TimChien112/LPM-final-project/component reference files/PCB layout pictures/TPS62822(BUCK).JPG

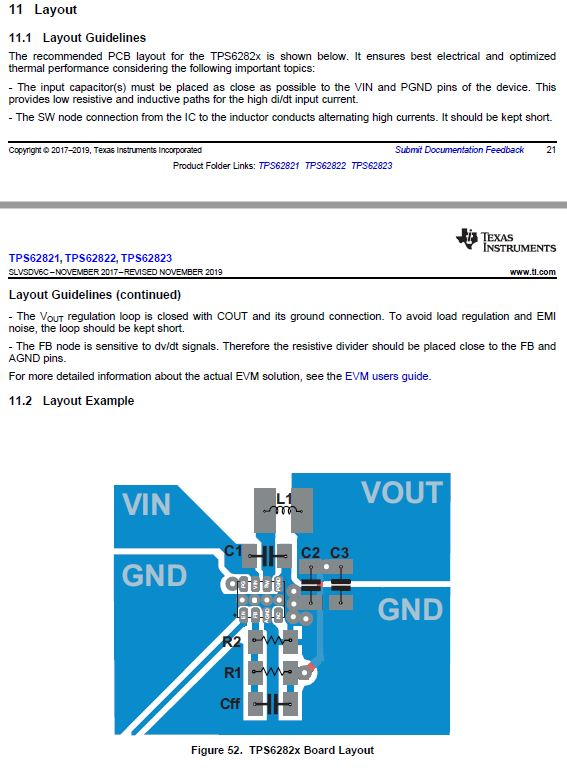
component reference files/PCB layout pictures/TPS62822(BUCK).JPG
