TimChien112/LPM-final-project/component reference files/PCB layout pictures/GPS.JPG

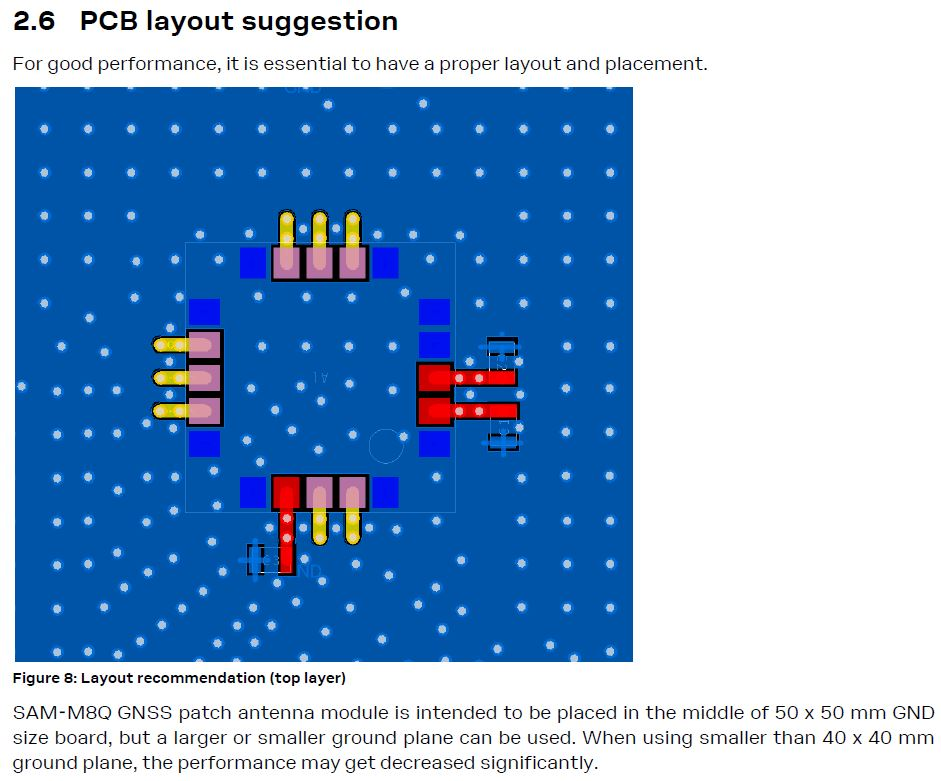
component reference files/PCB layout pictures/GPS.JPG
