TimChien112/LPM-final-project/component reference files/recommended Schematics/BQ2407x DK sch.JPG

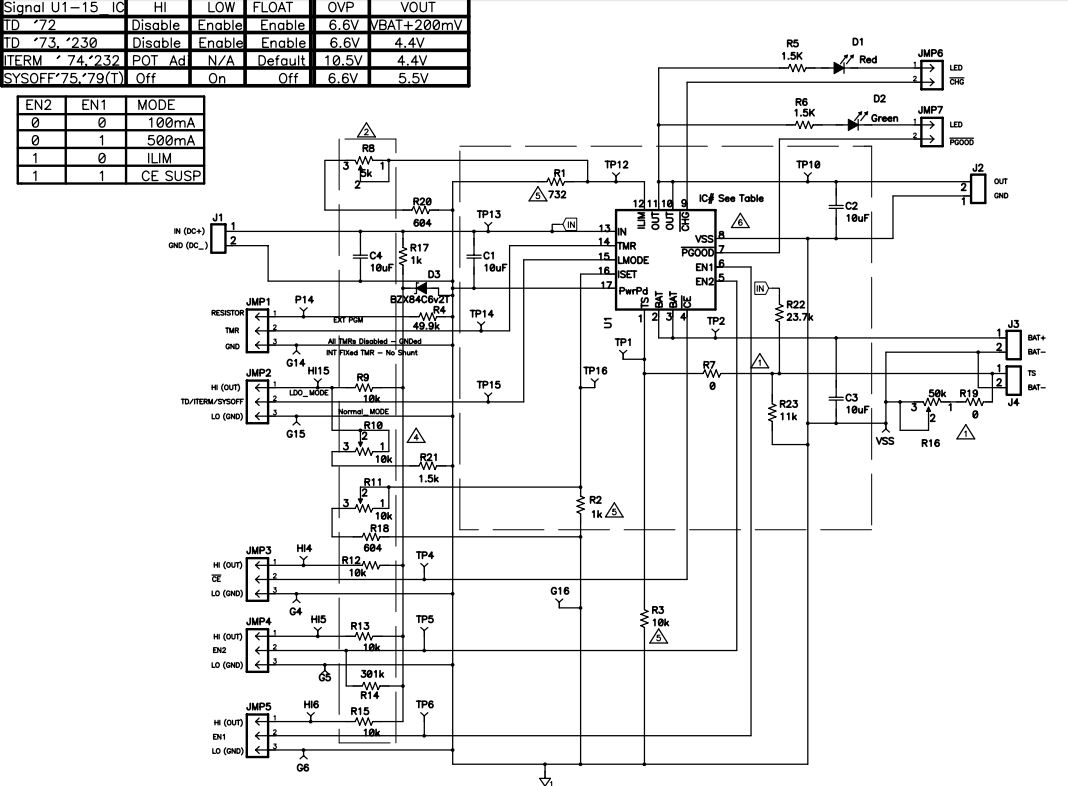
component reference files/recommended Schematics/BQ2407x DK sch.JPG
