TimChien112/LPM-final-project/component reference files/recommended Schematics/BQ24079  sch.JPG

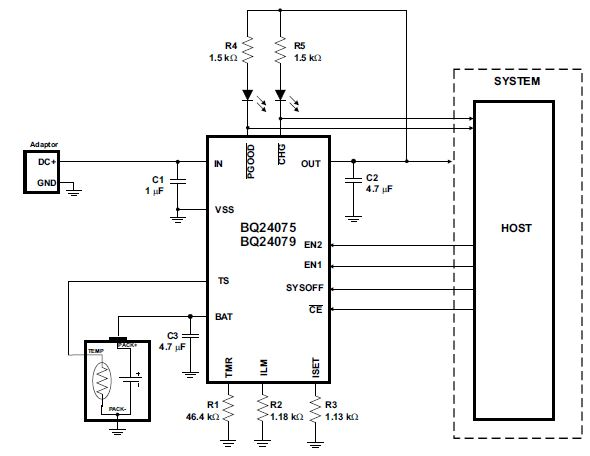
component reference files/recommended Schematics/BQ24079 sch.JPG
