TimChien112/LPM-final-project/component reference files/recommended Schematics/TPS2111a DK sch.JPG

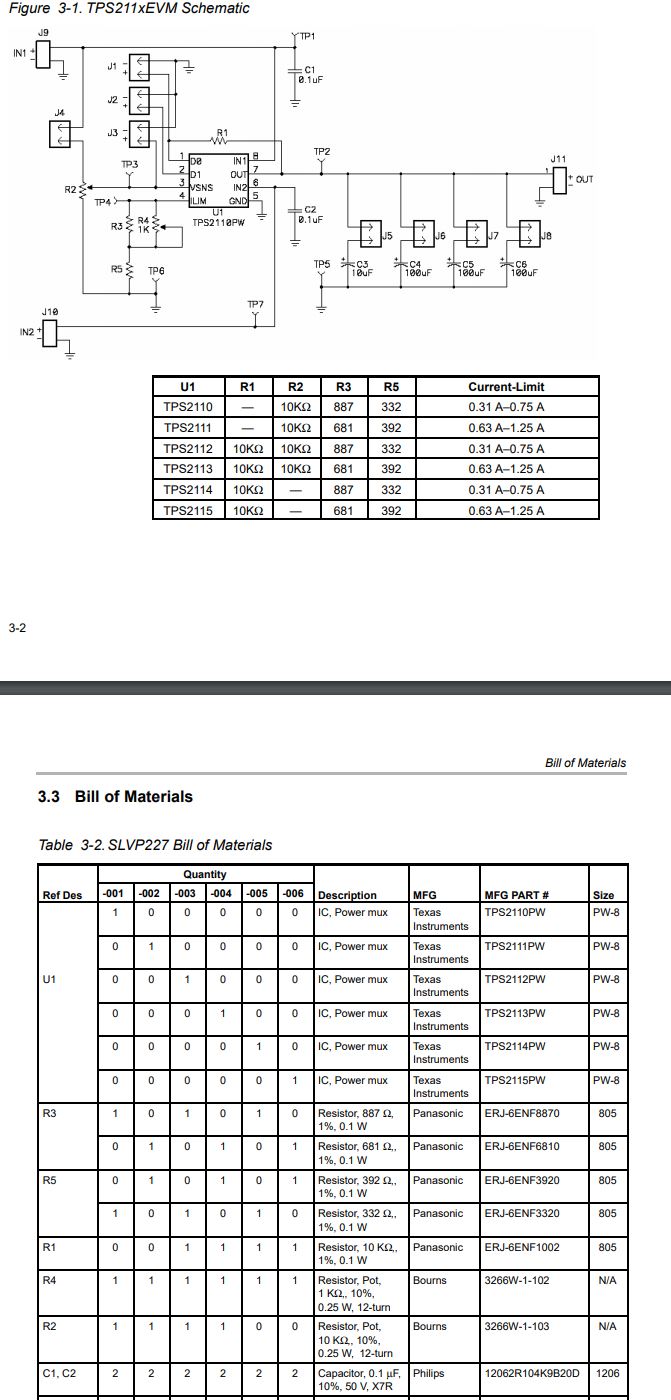
component reference files/recommended Schematics/TPS2111a DK sch.JPG
