TimChien112/LPM-final-project/component reference files/MCU/EFR32MG1-BRD4154A-A00-bom.xlsx

P/N: | BRD4154A
Revision: | A00
Description: | EFR32MG Firefly 2.4 GHz 19.5 dBm Radio Board
Revised: | Wednesday, April 06, 2016
Item | Quantity | Reference | Value | Manufacturer | Manufacturers Part Number | Description | Tolerance | Rating | Technology | Not Mounted
1 | 1 | AT1 | INVERTED_F
2 | 1 | C1 | 2P0 | Murata | GRM1555C1H2R0WA01 | CAP CER C0G 2pF 50V +-0.05pF | ±0.05P | 50V | C0G
3 | 1 | C2 | 1P0 | Murata | GRM1555C1H1R0WA01 | CAP CER C0G 1.0pF 50V +-0.05pF | ±0.05P | 50V | C0G
4 | 1 | C102 | 100P |  |  | CAP CER C0G 100pF 50V 5% | 5% | 50V | C0G
5 | 2 | C103,C107 | 10P |  |  | CAP CER NP0 10pF 50V 5% | 5% | 50V | C0G
6 | 1 | C106 | 220N |  |  | CAP CER X7R 220nF 16V 10% | 10% | 16V | X7R
7 | 2 | C110,C123 | 10U |  |  | CAP CER X5R 10uF 6.3V 20% | 20% | 6.3V | X5R
8 | 4 | C111,C115,C116,C118 | 1U |  |  | CAP CER X5R 1uF 25V 10% | 10% | 25V | X5R
9 | 1 | C113 | 10N |  |  | CAP CER X7R 10nF 16V 10% | 10% | 16V | X7R
10 | 6 | C119,C200,C201,C203,C207,C209 | 100N |  |  | CAP CER X7R 100nF 16V 10% | 10% | 16V | X7R
11 | 1 | C205 | 10U |  |  |  |  |  | X5R | NM
12 | 1 | L1 | 1N8 | Murata | LQP15MN1N8W02 | INDUCTOR 1.8nH 280mA +-0.05nH | ±0.05N
13 | 1 | L2 | 3N0 | Murata | LQP15MN3N0W00 | INDUCTOR 3.0nH 190mA +-0.05nH | ±0.05N
14 | 1 | L100 | CBF102WB | Würth Electronics | 74279266 | FERRITE BEAD 1000R 200mA
15 | 1 | L101 | 4U7 | Murata | LQH3NPN4R7MM0L | INDUCTOR POWER 4.7uH 1.25A 20%
16 | 2 | L102,L103 | BLM18AG601SN1 | Murata | BLM18AG601SN1
17 | 1 | PCB1 | PCB4154A |  | PCB4154A Rev. A01
18 | 1 | P1 | U.FL | Hirose | U.FL-R-SMT-1
19 | 2 | P200,P201 | SOCKET_2X20_1.27MM_SMD | Samtec | SFC-120-T2-L-D-A-K-TR | CONN SOCKET STRIP 1.27mm
20 | 3 | R1,R201,R210 | 0R |  |  | RES 0R Imax 2A JUMPER
21 | 2 | R2,R211 | 0R |  |  |  |  |  |  | NM
22 | 1 | R100 | 1R |  |  | RES 1R 1/16W 1% 200ppm
23 | 1 | R200 | 10K |  |  | RES 10K 1/16W 1% 100ppm
24 | 4 | R202,R203,R204,R205 | 4K7 |  |  | RES 4K7 1/16W 1% 100ppm
25 | 1 | SH100 | RF_SHIELD_FRAME_BMI-S-203-F | Laird Technologies | BMI-S-203-F |  |  |  |  | NM
26 | 1 | SH101 | RF_SHIELD_COVER_BMI-S-203-C | Laird Technologies | BMI-S-203-C |  |  |  |  | NM
27 | 17 | TPJ1,TPJ2,TPJ3,TPJ4,TPJ5,TPJ6,TPJ7,TPJ8,TPJ9,TPJ10,TPJ11,TPJ12,TPJ13,TPJ14,TPJ15,TPJ16,TPJ17 | TPJ_SMD
28 | 1 | U1 | EFR32MG1P732F256GM32 | Silicon Labs | EFR32MG1P732F256GM32-B0
29 | 1 | U200 | 24AA024 | Microchip | 24AA024T-I/MNY | IC EEPROM 2KBIT SERIAL
30 | 1 | U201 | EFM8SB10F8G-QFN20 | Silicon Labs | EFM8SB10F8G-A-QFN20 | IC MCU
31 | 1 | X1 | 38.4MHz | KDS | DSX211SH 38.4 MHz 1ZZNAE38400AB0A
32 | 1 | X2 | 32.768kHz | Micro Crystal AG | CM8V-T1A, 32768Hz, 12.5pF, +/- 20ppm
