TimChien112/LPM-final-project/Project Outputs for PCB_Project/PCB_Project.xlsx

Comment | Description | Designator | Footprint | LibRef | Quantity
1206C 100NF |  | C1, C2 | 1206-CAP | 1206C 100NF | 2 | 10
0805C 10UF |  | C3, C4 | 0805-CAP | 0805C 10UF | 2 | 10
0603C 4U7F |  | C5, C19, C25, C27 | 0603-CAP | 0603C 4U7F | 4 | 12
0603C 120PF |  | C6 | 0603-CAP | 0603C 120PF | 1 | 3
1210C 22UF |  | C7, C8 | 1210-CAP | 1210C 22UF | 2 | 3
0603C 10UF |  | C9, C15, C21, C31 | 0603-CAP | 0603C 10UF | 4 | 12
0603C 1UF |  | C10, C20, C22 | 0603-CAP | 0603C 1UF | 3 | 10
0603C 10NF |  | C11, C12, C13, C14, C16, C17, C32 | 0603-CAP | 0603C 10NF | 7 | 21
0603C 100NF |  | C18, C23, C24, C26, C34 | 0603-CAP | 0603C 100NF | 5 | 15
47uF |  | C28, C29, C30 | 0805-CAP | 0805C 47UF | 3 | 10
0603C 68PF |  | C33 | 0603-CAP | 0603C 68PF | 1 | 3
LEDR |  | D1, D4 | 0603-LED | 0603 LEDR | 2 | 10
LEDG |  | D2, D3, D5, D6 | 0603-LED | 0603 LEDG | 4 | 13
ESD_USB |  | E1 | ESD_USB | ESD_USB | 1 | 3
ESD_RS |  | E2, E3 | ESD_RS | ESD_RESET | 2 | 6
Inductor 470NH |  | L1 | Inductor 470NH | Inductor 470NH | 1 | 3
Ferrite Bead |  | L2 | 0603-FerritBead | Ferrite Bead | 1 | 3
Inductor 4U7H |  | L3 | Inductor 4U7H | Inductor 4U7H | 1 | 3
2pins_connector | Bat_connector | P1, P2 | 2_PINS_2.54 | 2pins_connector | 2
ZX62D-B-5P8 | USB - micro B USB 2.0 Receptacle Connector 5 Position Surface Mount, Right Angle; Through Hole | P3 | *HRS_ZX62D-B-5P8_ZX62D-B-5P8(Primary) | ZX62D-B-5P8 | 1 | 3
SWO |  | P4 | 4_PINS_2.54 | 4pins_connector | 1
6pins_connector |  | P5 | 6_PINS_2.54 | 6pins_connector | 1
0805R 5K1R |  | R1, R2 | 0805-RES | 0805R 5K1R | 2 | 10
0603R 1KR |  | R3, R6 | 0603-RES | 0603R 1KR | 2 | 10
0603R 1K5R |  | R4, R5, R28, R31 | 0603-RES | 0603R 1K5R | 4 | 12
0603R 1K07R |  | R7 | 0603-RES | 0603R 1K07R | 1 | 20 | ?
0603R 46K4R |  | R8 | 0603-RES | 0603R 46K4R | 1 | 10
0603R 10KR |  | R9, R21, R22, R23 | 0603-RES | 0603R 10KR | 4 | 12
0805R 100KR |  | R10, R12 | 0805-RES | 0805R 100KR | 2 | 10
0805R 453KR |  | R11 | 0805-RES | 0805R 453KR | 1 | 3
3KR |  | R13, R14 | 0603-RES | 0603R 3KR | 2 | 10
0603R NC |  | R15, R16, R17, R18 | 0603-RES | 0603R NC | 4
0603R 1R |  | R19, R24, R25, R29, R30 | 0603-RES | 0603R 1R | 5 | 15
0603R 100R |  | R20, R32 | 0603-RES | 0603R 100R | 2 | 10
0603R 47R |  | R26, R27 | 0603-RES | 0603R 47R | 2 | 10
PTS810 | Tactile Switch SPST-NO Top Actuated Surface Mount | SW1, SW2 | *SW_PTS810_SJM_250_SMTR_LFS | PTS810_SJM_250_SMTR_LFS | 2 | 6
1pin_header |  | T1, T2, T3, T4, T5, T6, T7 | 1_PIN_2.54 | 1pin_header | 7
1pin_test |  | T8, T9, T10 | 1_PIN_test | 1pin_test | 3
 |  | T11, T12, T13, T14 | 1_PIN_test | 1pin_header | 4
 |  | T15 | 1_PIN_2.54 | 1pin_header | 1
TPS2111APW | OR Controller Source Selector Switch N-Channel 2:1 8-TSSOP | U1 | *SOP65P640X120-8N | TPS2111APW | 1 | 3
BQ24079TRGTR |  | U2 | *QFN50P300X300X100-17N | BQ24079TRGTR | 1 | 3
TPS62822 |  | U3 | SON50P150X100_HS-9N | TPS62822 | 1 | 3
EFM32PG12_power |  | U4 | QFN50P700X700X90_HS-49N_ | EFM32PG12 | 1 | 3
MMA8452Q | Accelerometer X, Y, Z Axis , 2g, 4g, 8g 0.78Hz ~ 400Hz 16-QFN _3x3_ | U5 | *QFN-16_0.5MM | MMA8452Q | 1 | 3
SAM-M8Q-0-10 | CAM-M8 RF Receiver BeiDou, GLONASS, GNSS, GPS 1.575GHz -167dBm On-Board, Chip Module | U6 | SAMM8Q010 | SAM-M8Q-0-10 | 1 | 2
XB3-C-A1-UT-001 |  | U7 | XB24CAPIT-001 | XB3-C-A1-UT-001 | 1
battery |  |  |  |  | 1 | 1
solar |  |  |  |  | 1 | 1
