TimChien112/LPM-final-project/component reference files/PCB layout pictures/Accelerometer.JPG

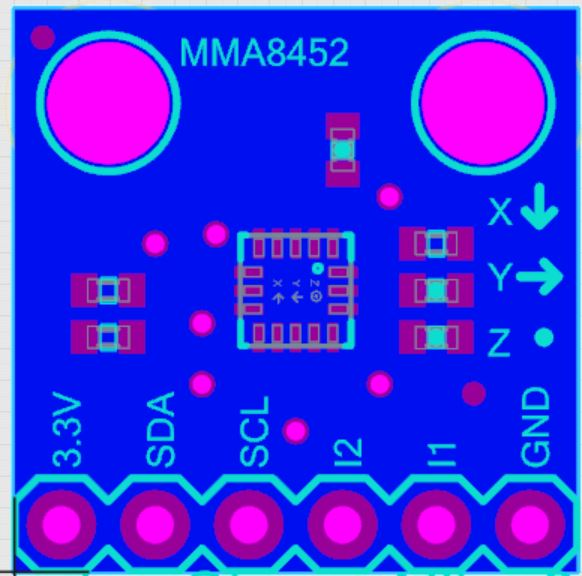
component reference files/PCB layout pictures/Accelerometer.JPG
