TimChien112/LPM-final-project/component reference files/PCB layout pictures/BQ24079(PMU).JPG

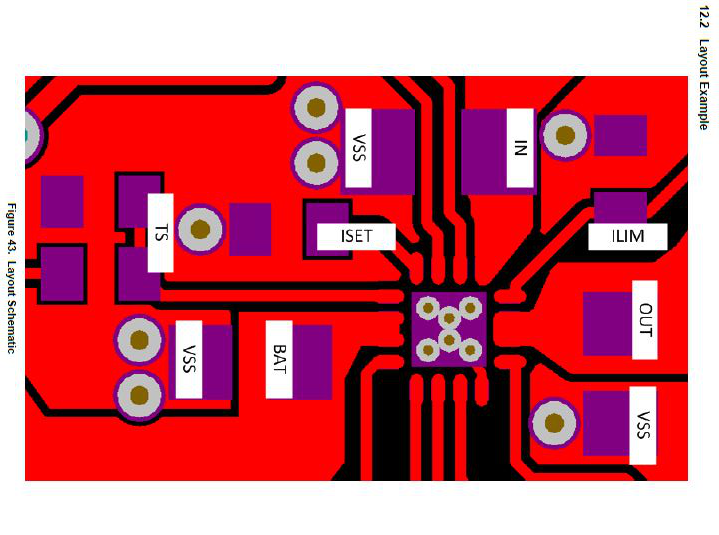
component reference files/PCB layout pictures/BQ24079(PMU).JPG
