TimChien112/LPM-final-project/component reference files/PCB layout pictures/ideal diode DK.JPG

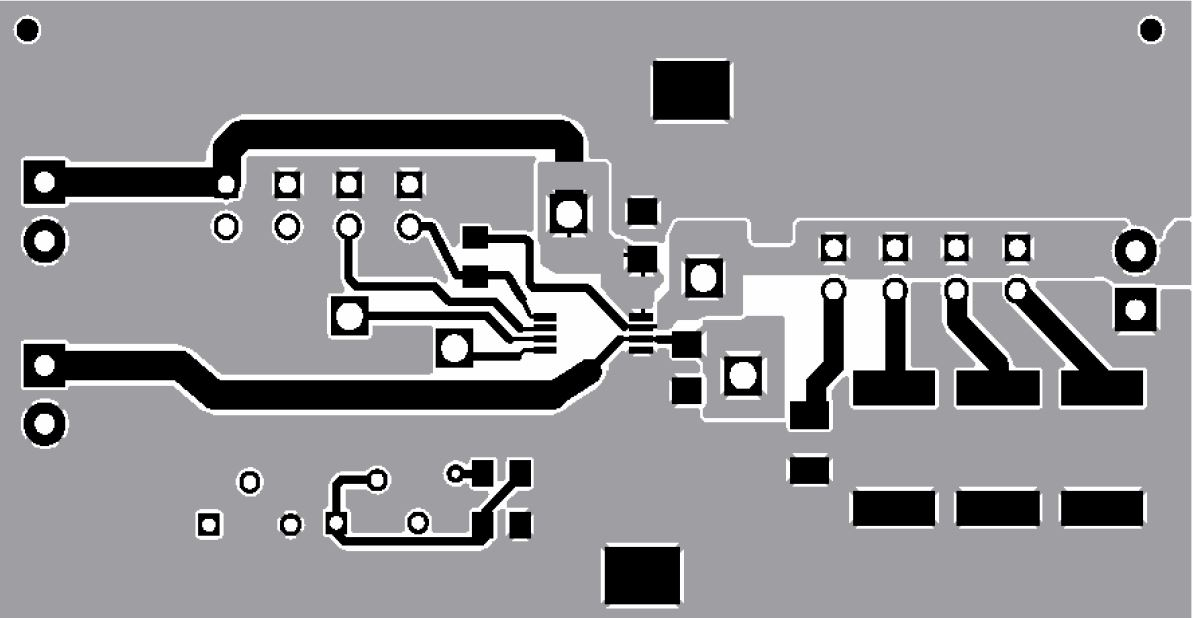
component reference files/PCB layout pictures/ideal diode DK.JPG
