TimChien112/LPM-final-project/component reference files/PCB layout pictures/LTE.JPG

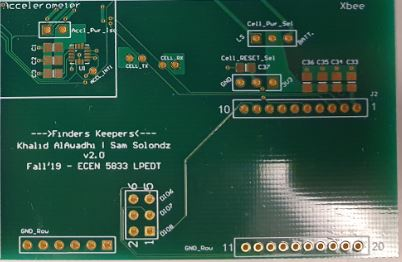
component reference files/PCB layout pictures/LTE.JPG
