TimChien112/LPM-final-project/component reference files/Unpopulated_back.jpg

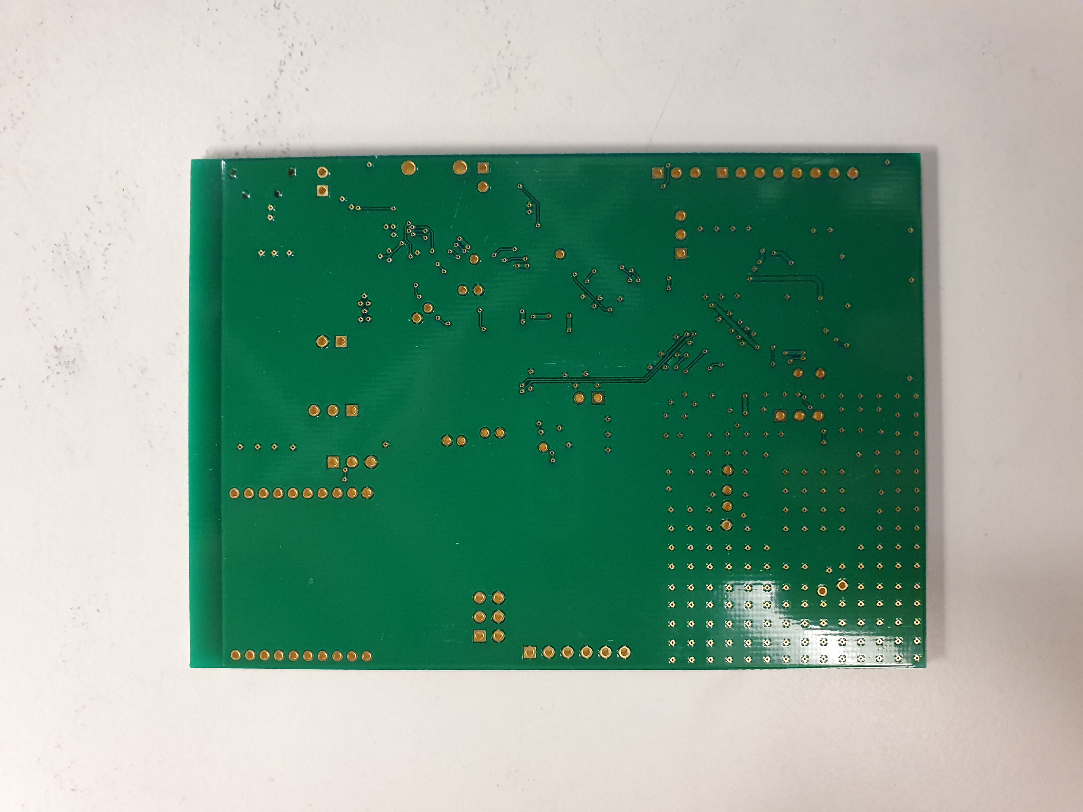
component reference files/Unpopulated_back.jpg
