TimChien112/LPM-final-project/component reference files/Unpopulated_front.jpg

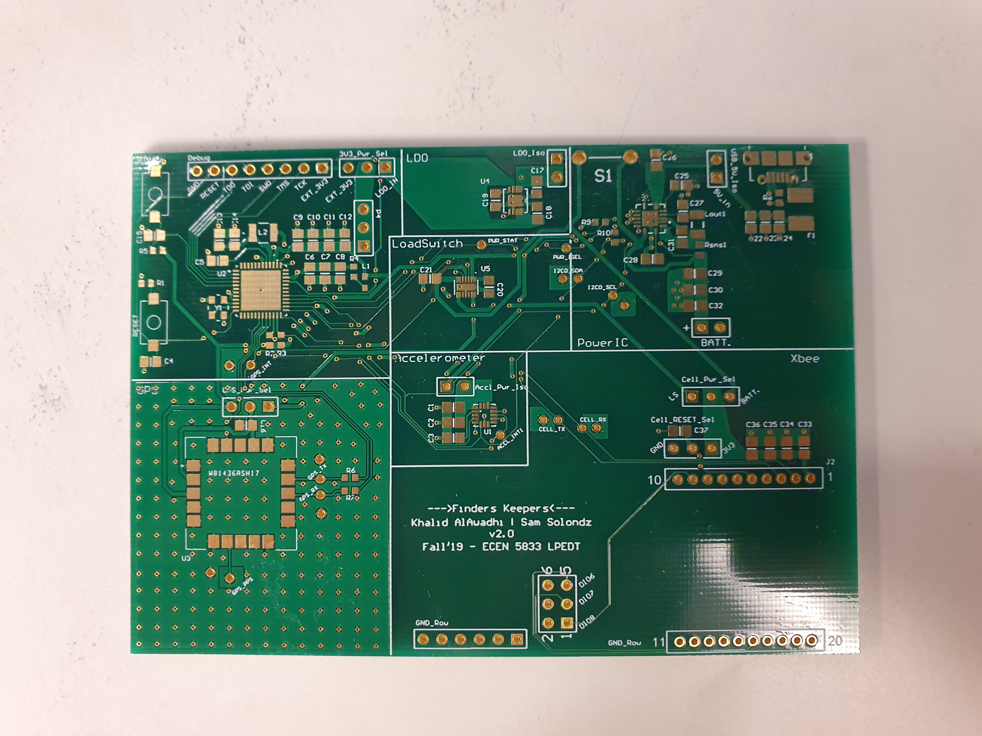
component reference files/Unpopulated_front.jpg
