TimChien112/LPM-final-project/PCB_Project.pdf

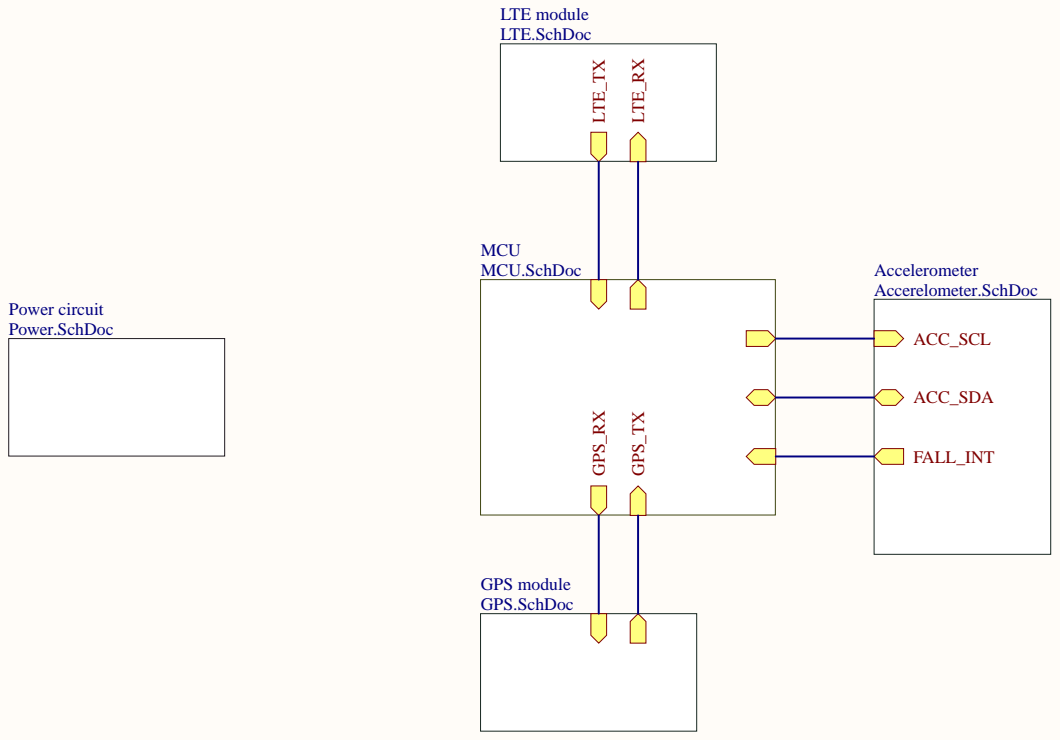
[picture p32: page 1]

Block diagram Title | *

Size: A4 | Number: 1. 1-1 | Revision:
2020/4/26 下午 10:35:18 Date: Time: | | Sheet of

C:\Users\Tim Chien\Google 雲端硬碟\LPM project\hardware\LPM-final-project\Block digram.SchDoc

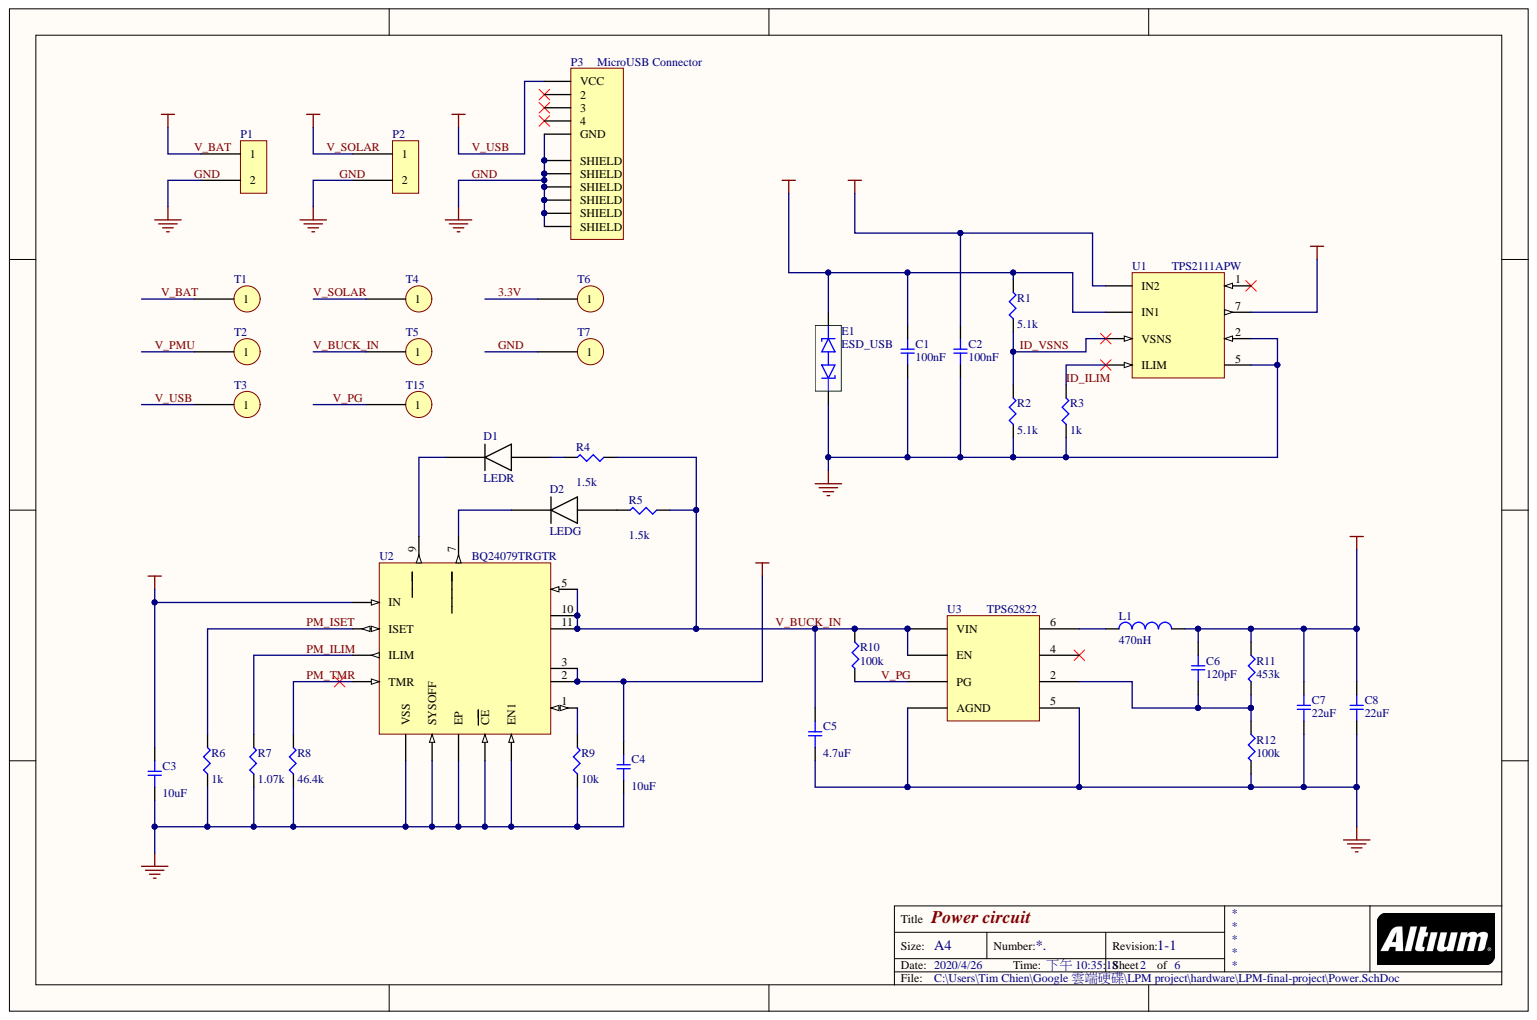
[picture p33: page 2]

PM_ISET

PM_ILIM | R10

Power circuit Title | * *

Size: A4 | Number: *. | Revision: 1-1

C:\Users\Tim Chien\Google 雲端硬碟\LPM project\hardware\LPM-final-project\Power.SchDoc

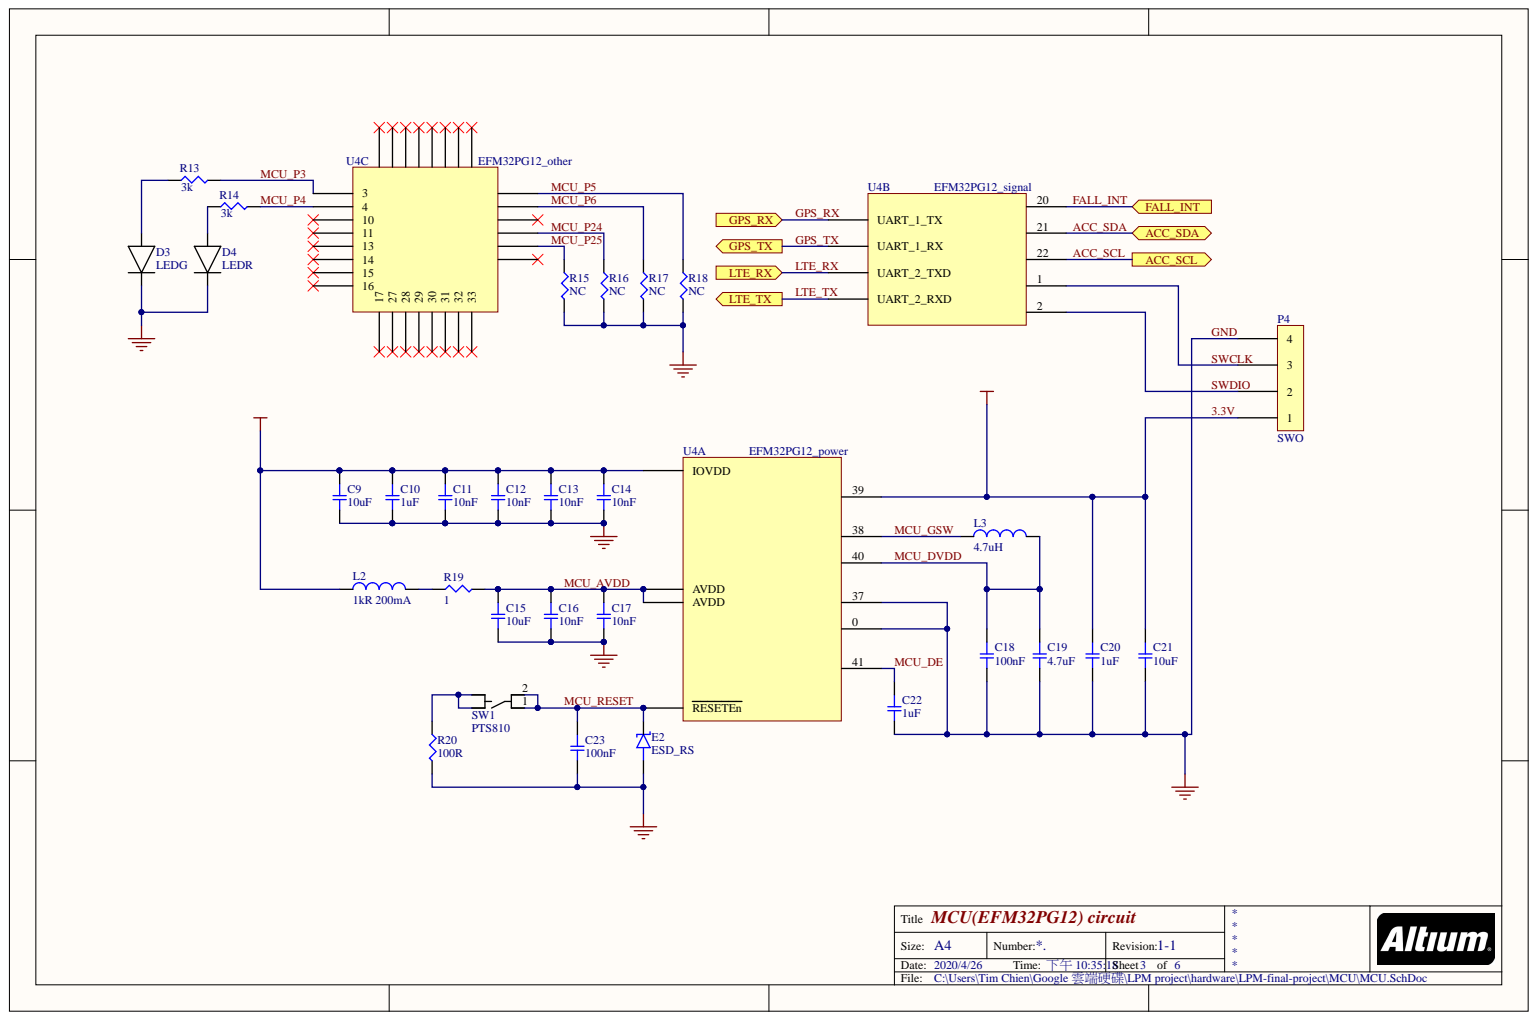
[picture p34: page 3]

MCU_P6

MCU_P24
MCU_P25

SWCLK

SWDIO

MCU(EFM32PG12) circuit Title | * *

Size: A4 | Number: *. | Revision: 1-1

C:\Users\Tim Chien\Google 雲端硬碟\LPM project\hardware\LPM-final-project\MCU\MCU.SchDoc

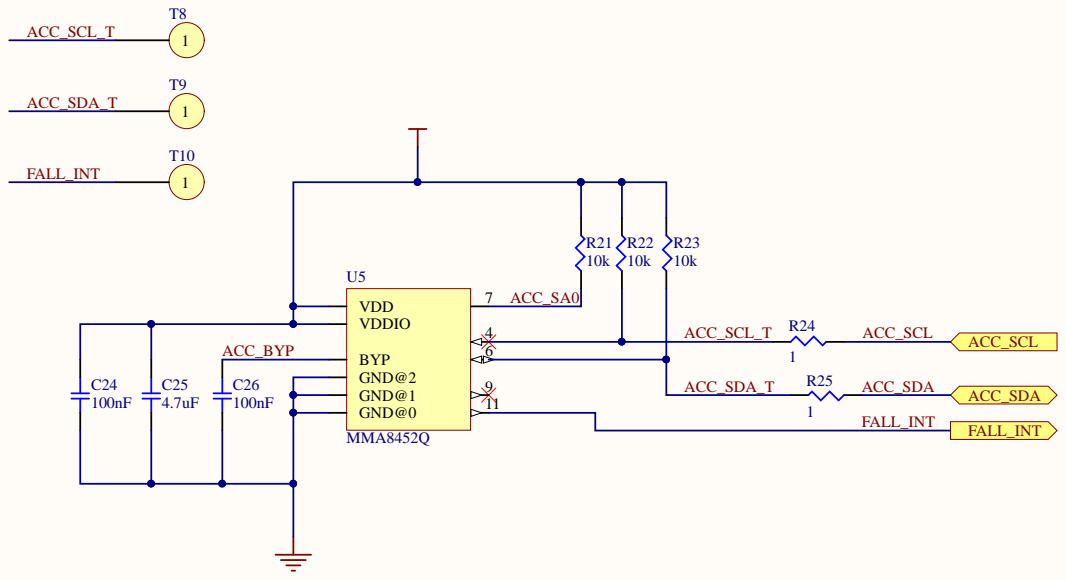
[picture p35: page 4]

Accelerometer (MMA8452Q) circuit Title | * *

Size: A4 | Number: *. | Revision: 1-1

C:\Users\Tim Chien\Google 雲端硬碟\LPM project\hardware\LPM-final-project\Acceleormeter\Accerelometer.SchDoc

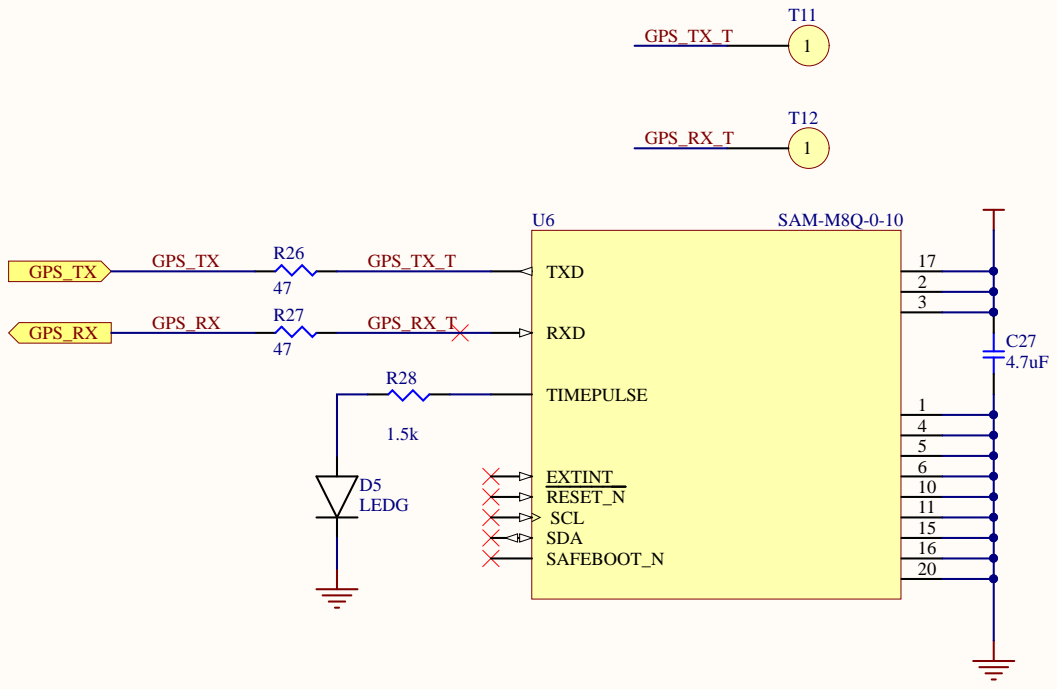
[picture p36: page 5]

GPS (SAM-M8Q) circuit Title | * *

Size: A4 | Number: *. | Revision: 1-1

C:\Users\Tim Chien\Google 雲端硬碟\LPM project\hardware\LPM-final-project\CAM-M8Q-0 Lib\GPS.SchDoc

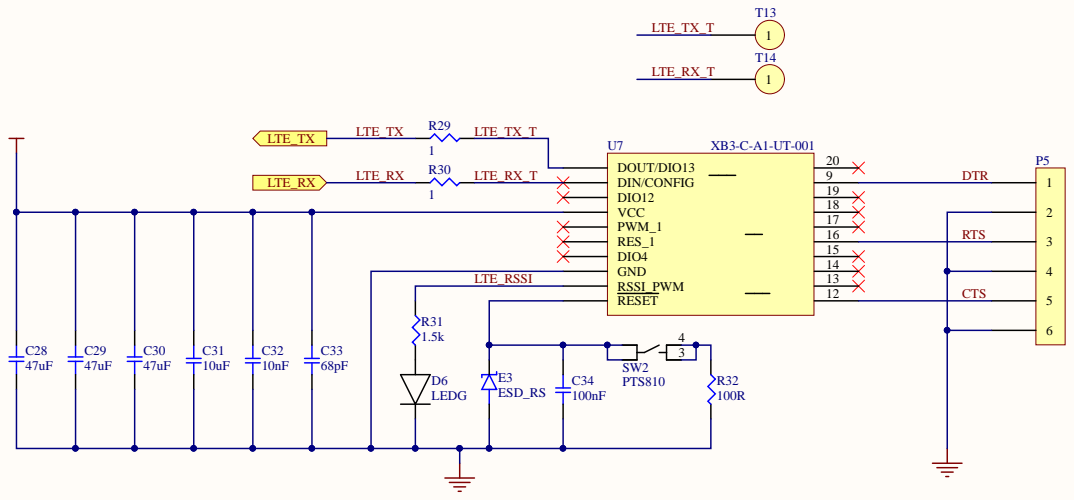
[picture p37: page 6]

LTE (XB3-C-A1-UT) circuit Title | *

Size: A4 | Number: *. | Revision: 1-1

C:\Users\Tim Chien\Google 雲端硬碟\LPM project\hardware\LPM-final-project\LTE\LTE.SchDoc

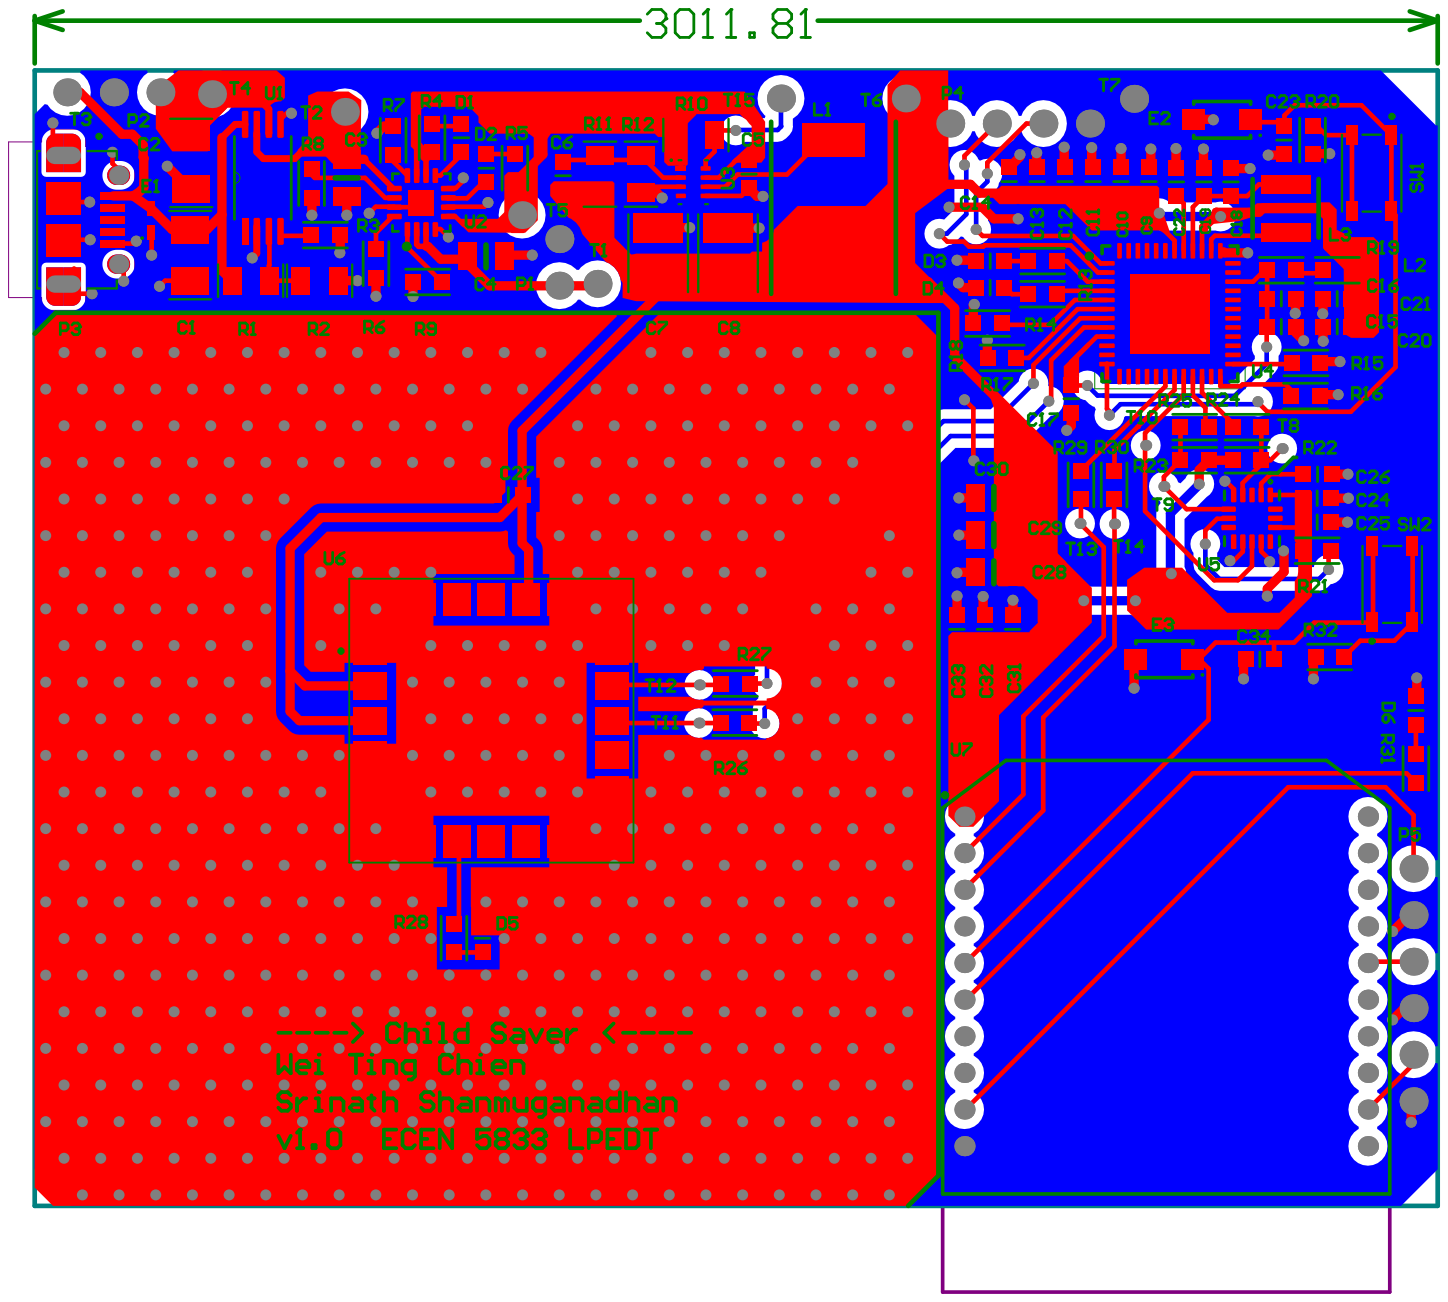
[picture p38: page 7]
