TimChien112/LPM-final-project/(list of files, drawings)

Other design files:
Acceleormeter/Accerelometer.SchDoc
Acceleormeter/MMA8452Q.PcbLib
Acceleormeter/MMA8452Q.SchLib
battery Management IC/BQ24079TRGTR.PcbLib
battery Management IC/BQ24079TRGTR.SchLib
battery Management IC/BQ24210DQCR.PcbLib
battery Management IC/BQ24210DQCR.SchLib
Block digram.SchDoc
Buck regulator/buck regulator.PcbLib
Buck regulator/TPS62822.PcbLib
Buck regulator/TPS62822.SchLib
CAM-M8Q-0 Lib/CAM-M8Q-0.PcbLib
CAM-M8Q-0 Lib/CAM-M8Q-0.SchLib
CAM-M8Q-0 Lib/GPS.PcbLib
CAM-M8Q-0 Lib/GPS.SchDoc
CAM-M8Q-0 Lib/GPS.SchLib
Connector/2.54_Connectors.SchLib
Connector/Connectors.PcbLib
Connector/ZX62D-B-5P8.PcbLib
Connector/ZX62D-B-5P8.SchLib
Connectors.SchLib
ideal diode/TPS2111APW.PcbLib
ideal diode/TPS2111APW.SchLib
LED/LED.SchLib
LTE/LTE.PcbLib
LTE/LTE.SchDoc
LTE/XBee_LTE.SchLib
MCU/EMF32PG.SchLib
MCU/EMF32QFN48PcbLib.PcbLib
MCU/MCU.SchDoc
passive components.PcbLib
passive components.SchLib
PCB_Project.PrjPcb
PCB_v1.PcbDoc
Power.SchDoc
switch/PTS810_SJM_250_SMTR_LFS.PcbLib
switch/PTS810_SJM_250_SMTR_LFS.SchLib
