TimChien112/LPM-final-project/(commit log)

2020-03-18 first commit for previous files
    [2.54_Connectors.SchLib, Accerelometer.SchDoc, BQ24079TRGTR.PcbLib, BQ24079TRGTR.SchLib, BQ24210DQCR.PcbLib, BQ24210DQCR.SchLib, Block digram.SchDoc, CAM-M8Q-0.PcbLib]
2020-03-18 add component reference files
    [EFR32MG1-BRD4154A-A00-bom.xlsx]
2020-03-19 Fixed one set of warning, added symbols, removed R from resistor
    [Accerelometer.SchDoc, GPS.SchDoc, LTE.SchDoc, MCU.SchDoc, Power.SchDoc, passive components.SchLib]
2020-03-19 schematic changes
    [Accerelometer.SchDoc, GPS.SchLib, MCU.SchDoc, Power.SchDoc, passive components.SchLib]
2020-03-19 3/10 03:55 schematic freeze
    [Accerelometer.SchDoc, BQ24079TRGTR.SchLib, GPS.SchDoc, GPS.SchLib, LTE.SchDoc, MCU.SchDoc, PCB_v1.PcbDoc, Power.SchDoc]
2020-03-20 PCB layout 3/20 freeze
    [2.54_Connectors.SchLib, Accerelometer.SchDoc, EMF32QFN48PcbLib.PcbLib, GPS.PcbLib, GPS.SchDoc, GPS.SchLib, LTE.SchDoc, MCU.SchDoc]
2020-03-21 PCB layout freezed 3/21
    [Accerelometer.SchDoc, LTE.SchDoc, MCU.SchDoc, PCB_v1.PcbDoc, Power.SchDoc, passive components.SchLib]
2020-03-23 fix layout problem 3/22
    [Connectors.PcbLib, PCB_v1.PcbDoc, Power.SchDoc, passive components.PcbLib]
2020-03-24 fix review 1 problems, except the thermal pad problems
    [2.54_Connectors.SchLib, Accerelometer.SchDoc, BQ24079TRGTR.PcbLib, Connectors.PcbLib, EMF32QFN48PcbLib.PcbLib, GPS.SchDoc, LTE.SchDoc, PCB_Project.PrjPcb]
2020-03-24 3/24 designators re-arrangement
    [Accerelometer.SchDoc, EMF32QFN48PcbLib.PcbLib, MCU.SchDoc, PCB_v1.PcbDoc]
2020-03-25 add USB connector
    [2.54_Connectors.SchLib, Connectors.PcbLib, PCB_v1.PcbDoc, Panasonic_ERJ_0603.PcbLib, Panasonic_ERJ_0805.PcbLib, Power.SchDoc, ZX62D-B-5P8.PcbLib, ZX62D-B-5P8.SchLib]
2020-03-25 fix all review#1 problem
    [2.54_Connectors.SchLib, BQ24079TRGTR.PcbLib, Connectors.PcbLib, EMF32QFN48PcbLib.PcbLib, LTE.PcbLib, LTE.SchDoc, MCU.SchDoc, MMA8452Q.PcbLib]
2020-03-25 fix all review#1 problem 3/25
    [PCB_v1.PcbDoc]
2020-03-26 fix most of the review#2 problems. except the thermal pad issue
    [BQ24079TRGTR.PcbLib, EMF32PG.SchLib, EMF32QFN48PcbLib.PcbLib, MCU.SchDoc, MMA8452Q.PcbLib, PCB_Project.PrjPcb, PCB_v1.PcbDoc, TPS62822.PcbLib]
2020-03-26 fix all problem and Design rule check pass
    [BQ24079TRGTR.PcbLib, BQ24079TRGTR.SchLib, EMF32PG.SchLib, EMF32QFN48PcbLib.PcbLib, MCU.SchDoc, PCB_v1.PcbDoc, Power.SchDoc]
2020-03-26 added gerber and drill output files
    [PCB_Project.csv, PCB_Project.xlsx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]
2020-03-26 add NC Drill File
2020-03-27 layout review#2 done. design rule check pass. solider mask para set to 1.8mils
    [BQ24079TRGTR.PcbLib, EMF32QFN48PcbLib.PcbLib, GPS.PcbLib, MMA8452Q.PcbLib, PCB_Project.PrjPcb, PCB_v1.PcbDoc, Power.SchDoc, TPS2111APW.PcbLib]
2020-03-27 fix all problems
    [PCB_Project.PrjPcb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]
2020-05-15 final version freezed
    [BQ24079TRGTR.PcbLib, EMF32QFN48PcbLib.PcbLib, GPS.SchDoc, LTE.SchDoc, MCU.SchDoc, MMA8452Q.PcbLib, PCB_Project.PrjPcb, PCB_Project.xlsx]
